HenryTanRidley/Exoknee/Mechanical/Photo/idlergear.jpg

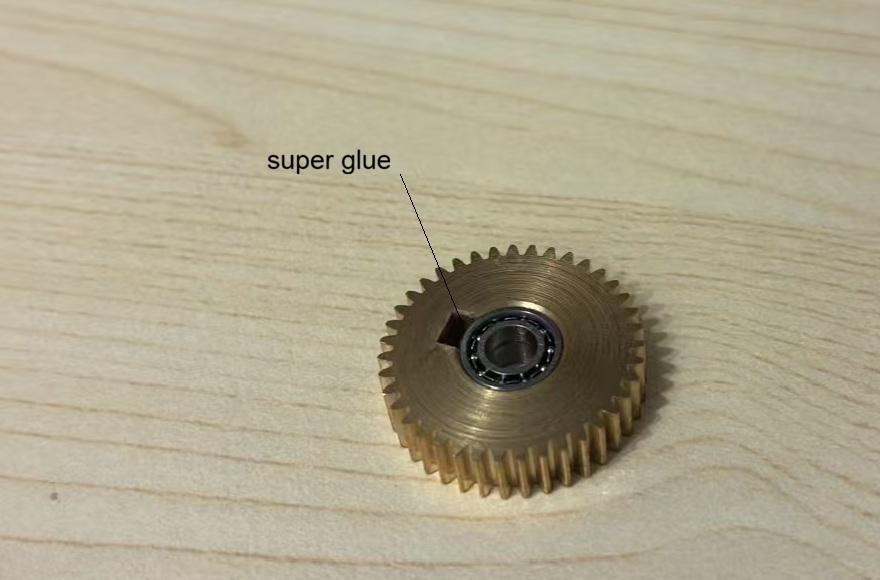
Mechanical/Photo/idlergear.jpg
