HenryTanRidley/Exoknee/Mechanical/Photo/note1.jpg

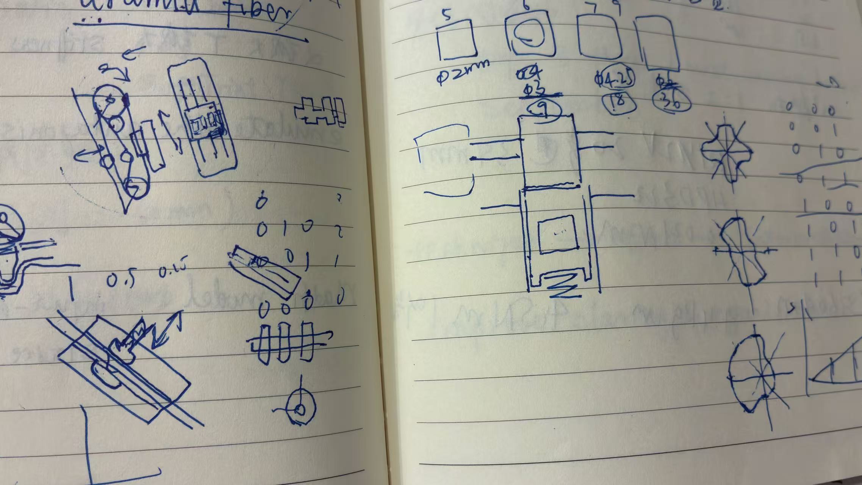
Mechanical/Photo/note1.jpg
