HenryTanRidley/Exoknee/Mechanical/Photo/camaxis.jpg

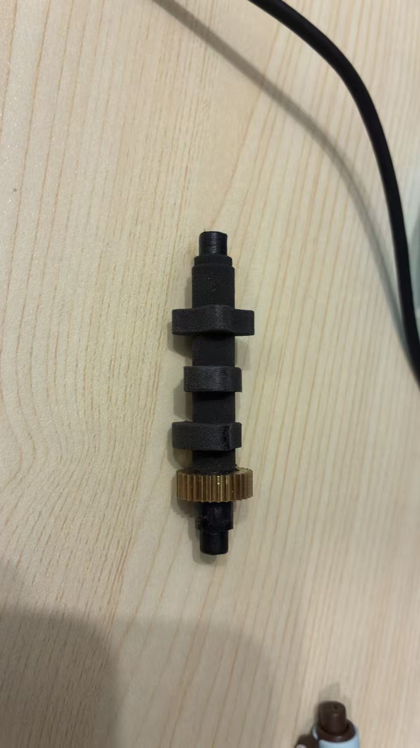
Mechanical/Photo/camaxis.jpg
