HenryTanRidley/Exoknee/Mechanical/Photo/note2.jpg

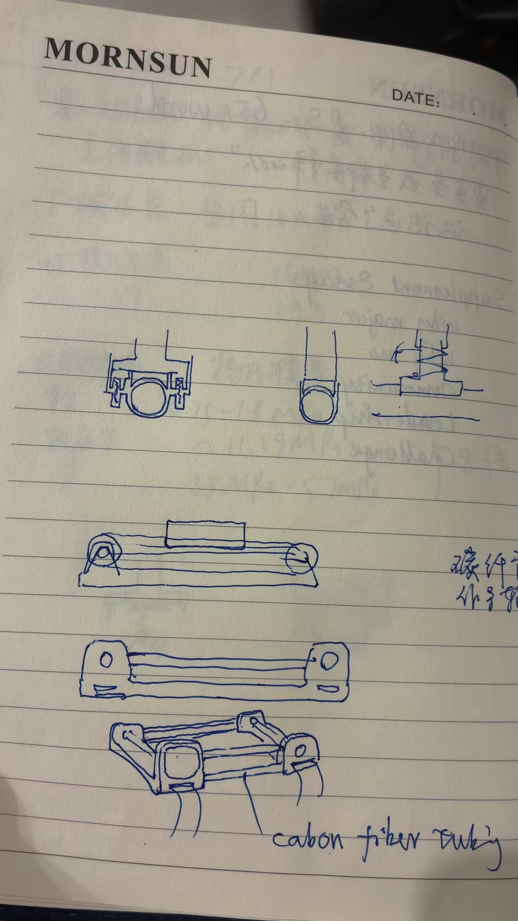
Mechanical/Photo/note2.jpg
