HenryTanRidley/Exoknee/Mechanical/Final/tuoban_yuan_prt.stp

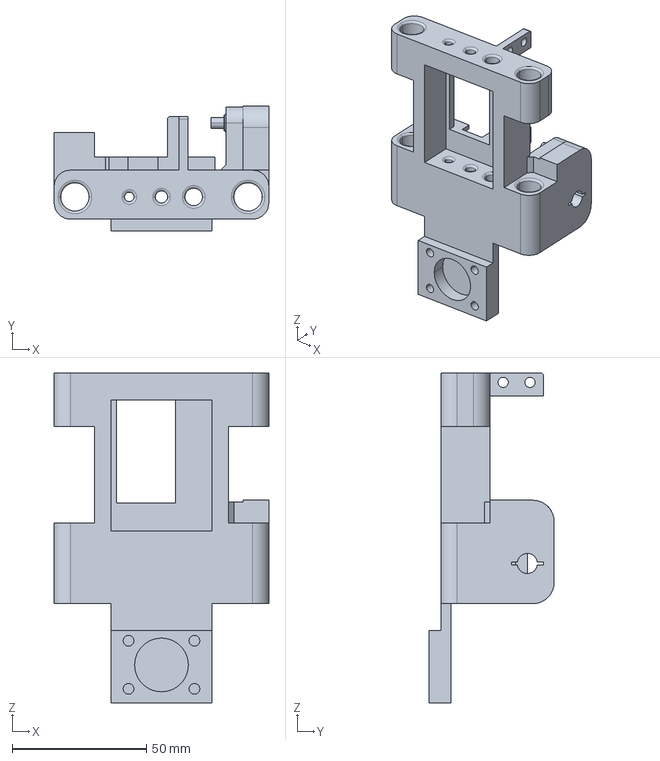
[picture p17: CAD file, 2026-08-20]
Mechanical/Final/tuoban_yuan_prt.stp
80.0 x 46.7 x 123.0 mm
