HenryTanRidley/Exoknee/Mechanical/jointcover.stp

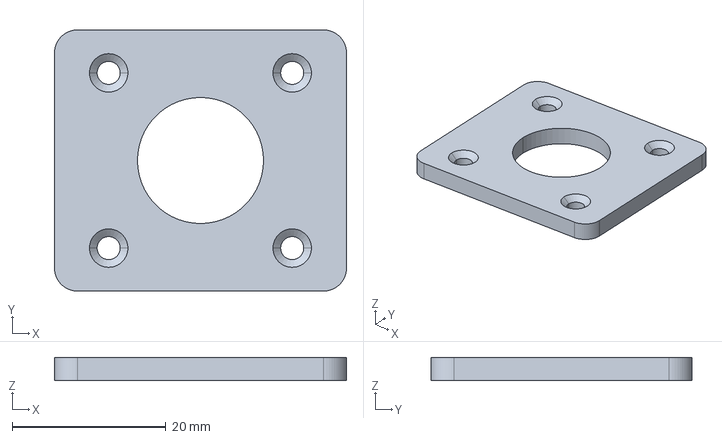
[picture p18: CAD file, 2026-07-24]
Mechanical/jointcover.stp
38.0 x 34.0 x 3.00 mm
