HenryTanRidley/Exoknee/Mechanical/link1.stp

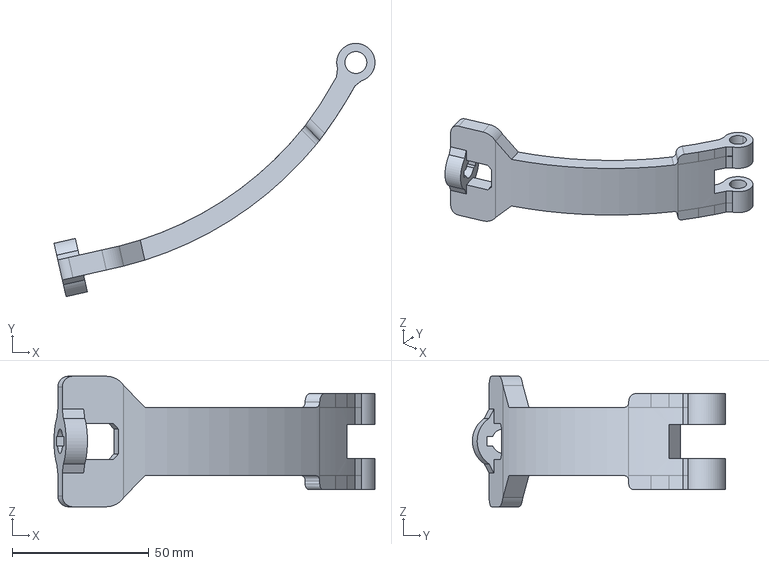
[picture p19: CAD file, 2026-07-24]
Mechanical/link1.stp
117.3 x 92.6 x 47.7 mm
