HenryTanRidley/Exoknee/Mechanical/Final/brake1_prt.stp

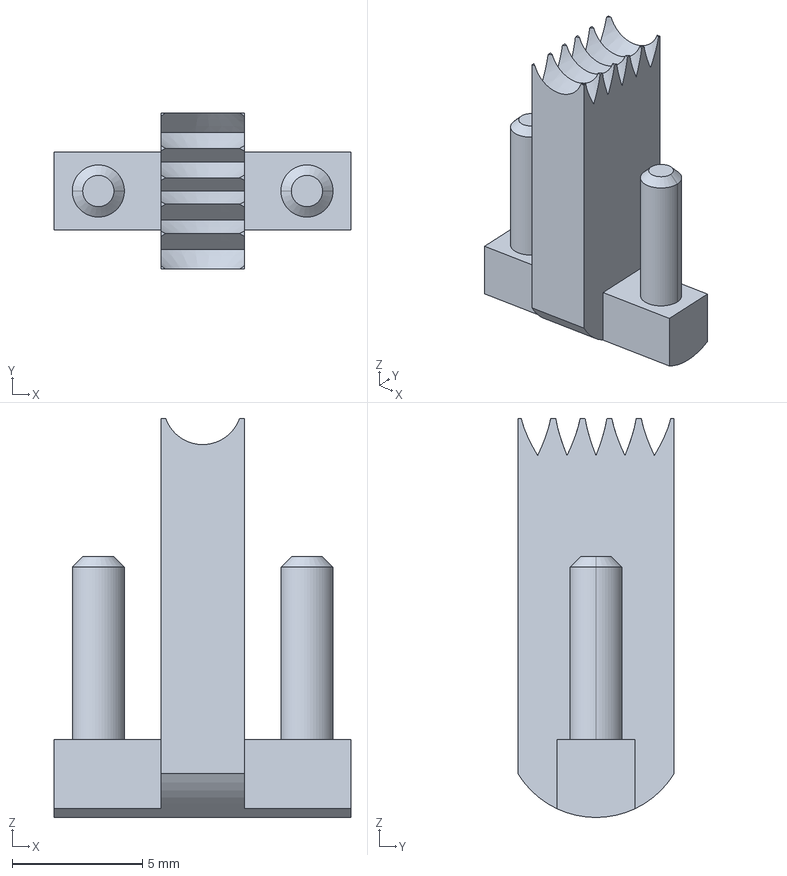
[picture p20: CAD file, 2026-08-11]
Mechanical/Final/brake1_prt.stp
11.4 x 6.00 x 15.3 mm
