HenryTanRidley/Exoknee/Mechanical/link3.stp

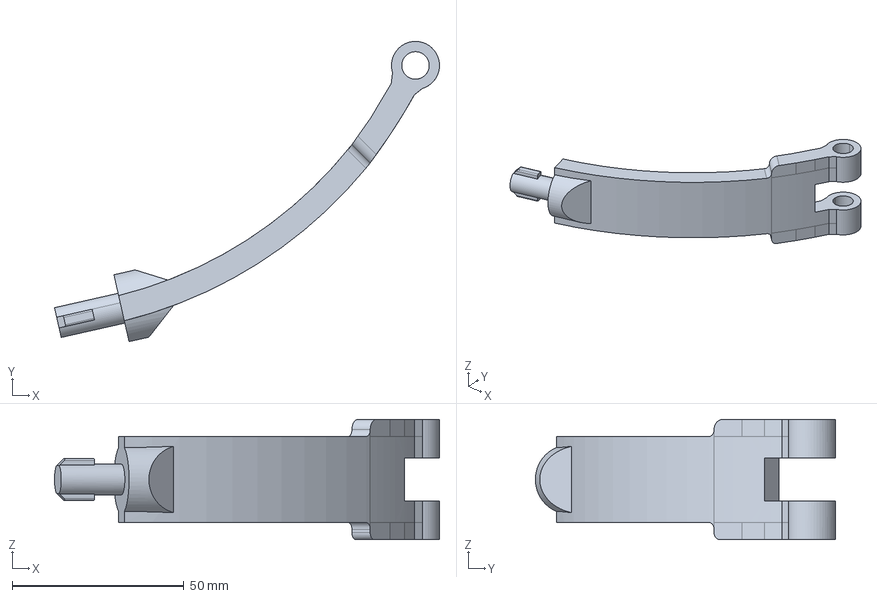
[picture p21: CAD file, 2026-07-24]
Mechanical/link3.stp
112.2 x 87.5 x 35.0 mm
