HenryTanRidley/Exoknee/Mechanical/Final/brake3_prt.stp

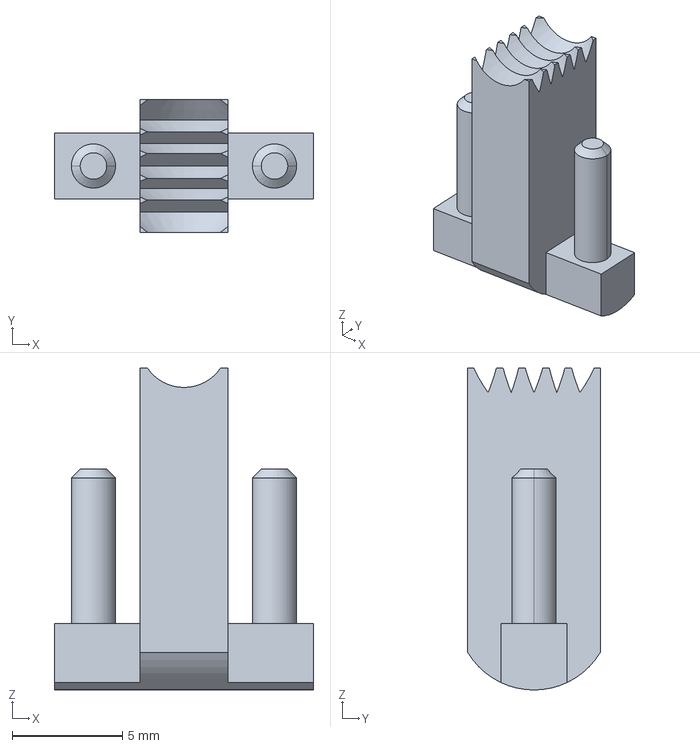
[picture p22: CAD file, 2026-08-11]
Mechanical/Final/brake3_prt.stp
11.7 x 6.00 x 14.6 mm
