HenryTanRidley/Exoknee/Mechanical/jointcover2.stp

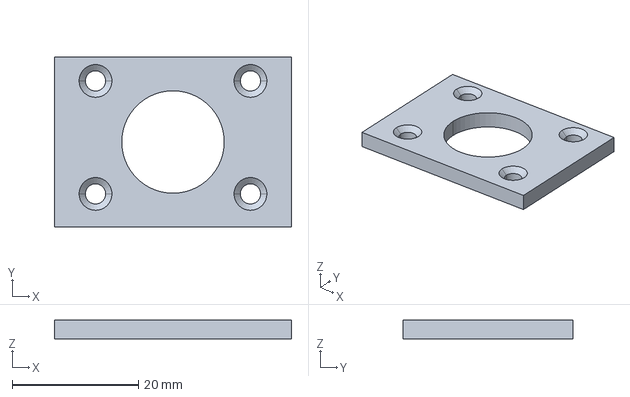
[picture p23: CAD file, 2026-07-24]
Mechanical/jointcover2.stp
37.6 x 27.0 x 3.00 mm
