HenryTanRidley/Exoknee/Mechanical/brake2.stp

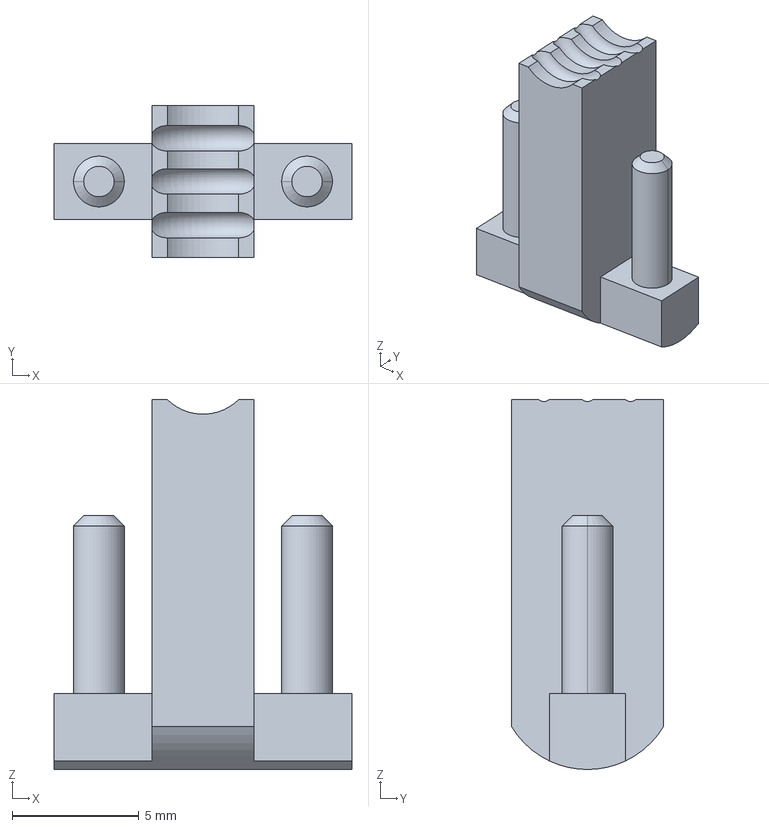
[picture p24: CAD file, 2026-07-24]
Mechanical/brake2.stp
11.7 x 6.00 x 14.6 mm
