HenryTanRidley/Exoknee/Mechanical/brake3.stp

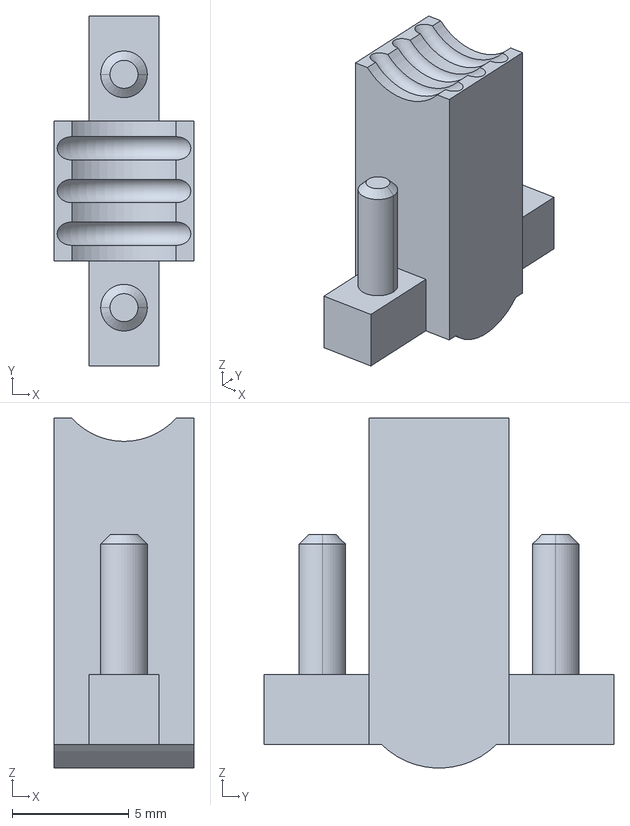
[picture p25: CAD file, 2026-07-24]
Mechanical/brake3.stp
6.00 x 15.0 x 15.0 mm
