HenryTanRidley/Exoknee/Mechanical/Final/rail_tubing_prt.stp

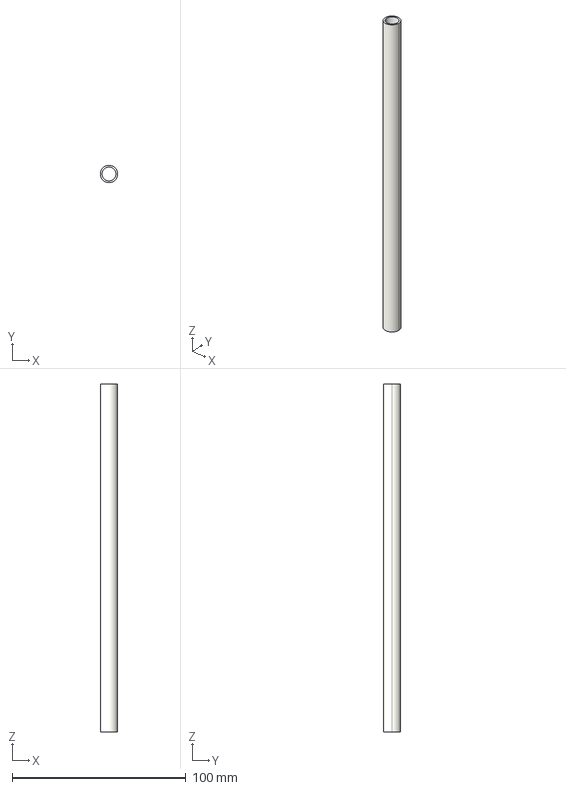
[picture p26: CAD file, 2026-08-09]
Mechanical/Final/rail_tubing_prt.stp
10.0 x 10.0 x 200.0 mm
