HenryTanRidley/Exoknee/Mechanical/brace2.stp

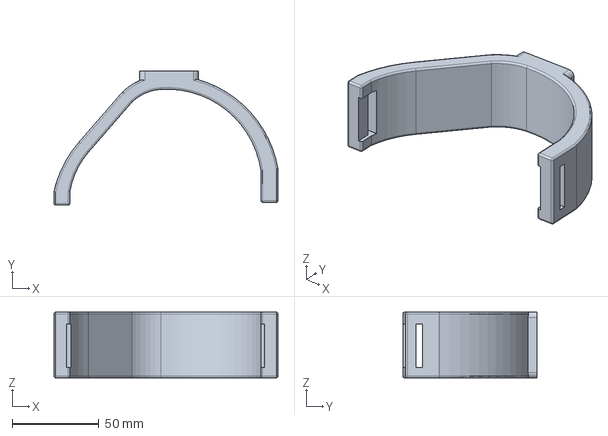
[picture p27: CAD file, 2026-07-24]
Mechanical/brace2.stp
129.3 x 77.6 x 38.0 mm
