HenryTanRidley/Exoknee/Mechanical/Final/35motor_prt.stp

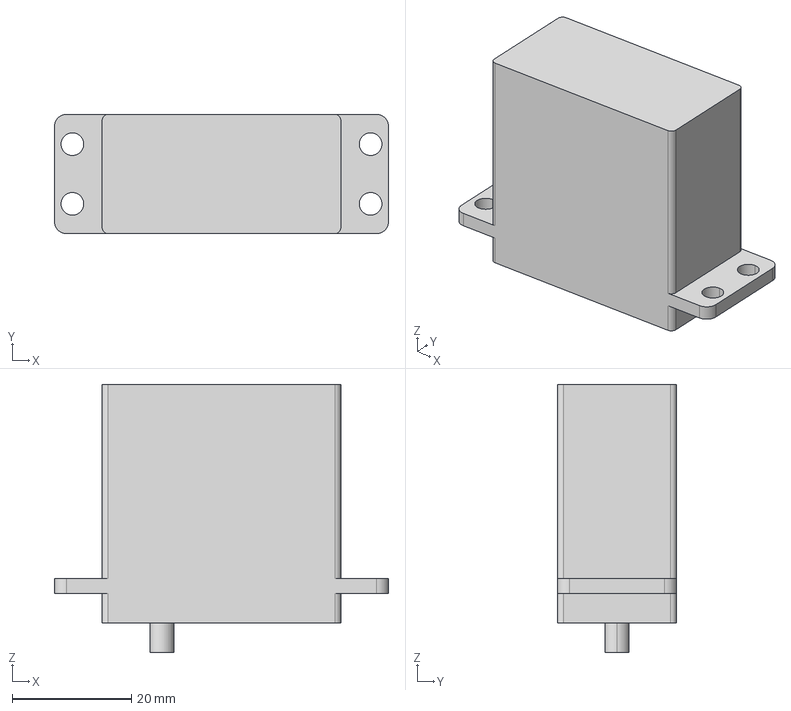
[picture p28: CAD file, 2026-08-09]
Mechanical/Final/35motor_prt.stp
56.0 x 20.0 x 45.0 mm
