HenryTanRidley/Exoknee/Mechanical/Final/link1_prt.stp

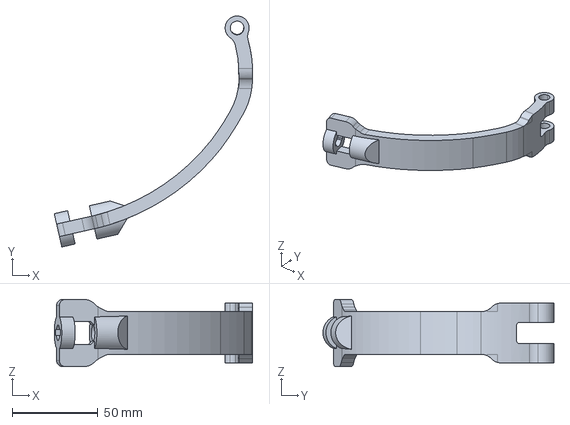
[picture p29: CAD file, 2026-08-09]
Mechanical/Final/link1_prt.stp
115.9 x 134.9 x 39.2 mm
