HenryTanRidley/Exoknee/Mechanical/joint1.stp

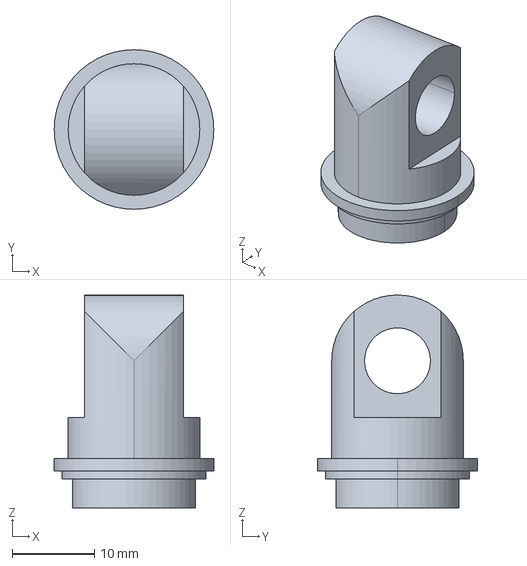
[picture p30: CAD file, 2026-07-24]
Mechanical/joint1.stp
19.4 x 19.4 x 25.9 mm
