HenryTanRidley/Exoknee/Mechanical/brake1.stp

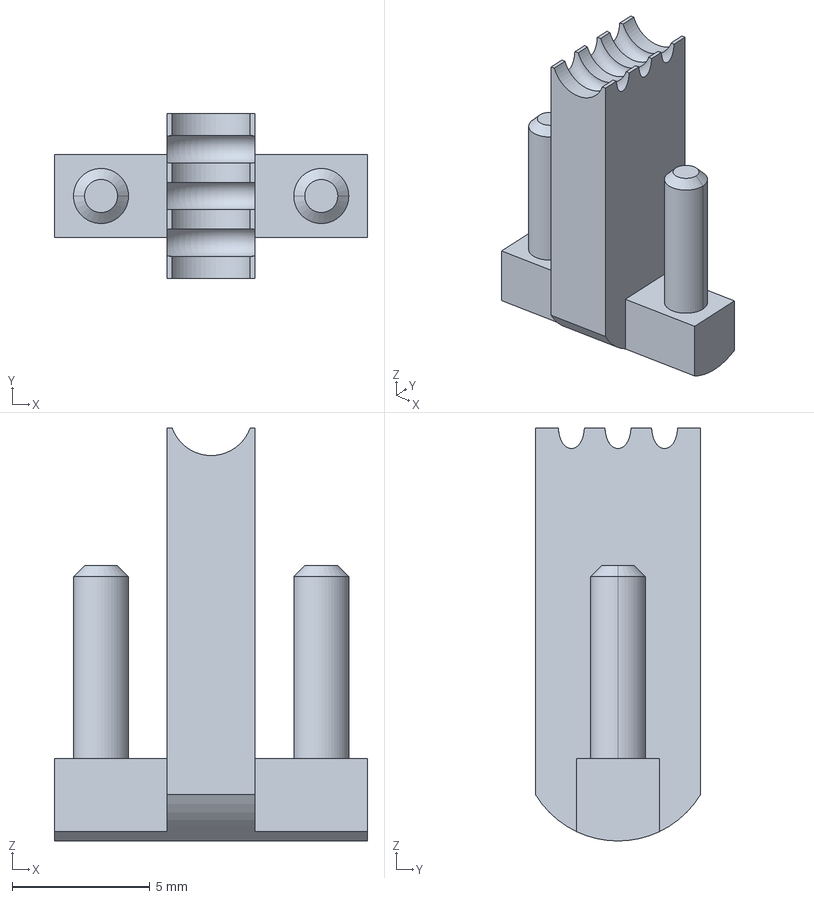
[picture p31: CAD file, 2026-07-24]
Mechanical/brake1.stp
11.4 x 6.00 x 15.0 mm
