HenryTanRidley/Exoknee/Mechanical/Final/bear3_prt.stp

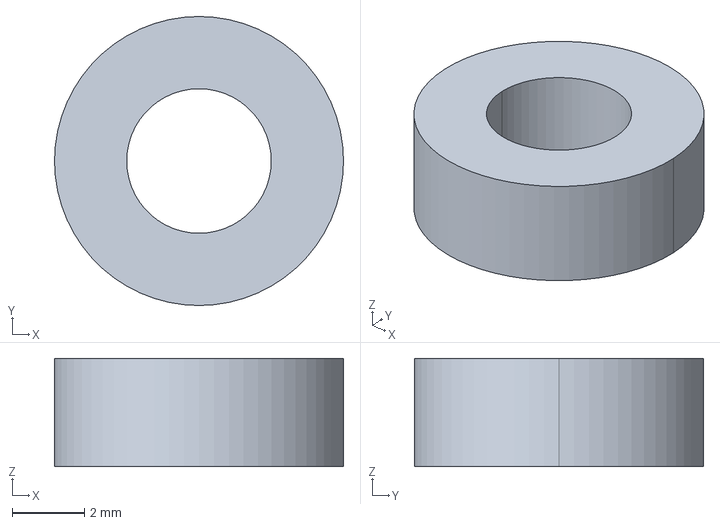
[picture p32: CAD file, 2026-08-09]
Mechanical/Final/bear3_prt.stp
8.00 x 8.00 x 3.00 mm
