HenryTanRidley/Exoknee/Mechanical/Final/bear4-2_prt.stp

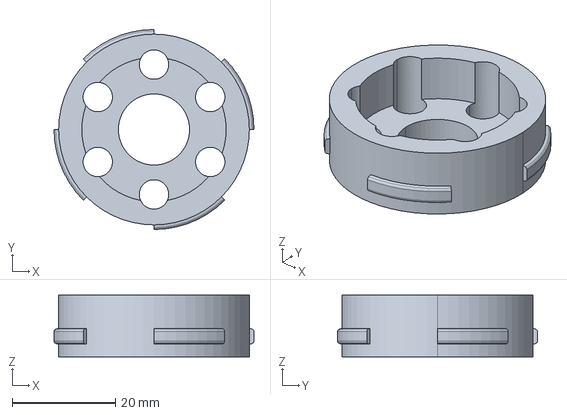
[picture p33: CAD file, 2026-08-09]
Mechanical/Final/bear4-2_prt.stp
38.8 x 38.8 x 12.0 mm
