HenryTanRidley/Exoknee/Mechanical/Final/wheel2_prt.stp

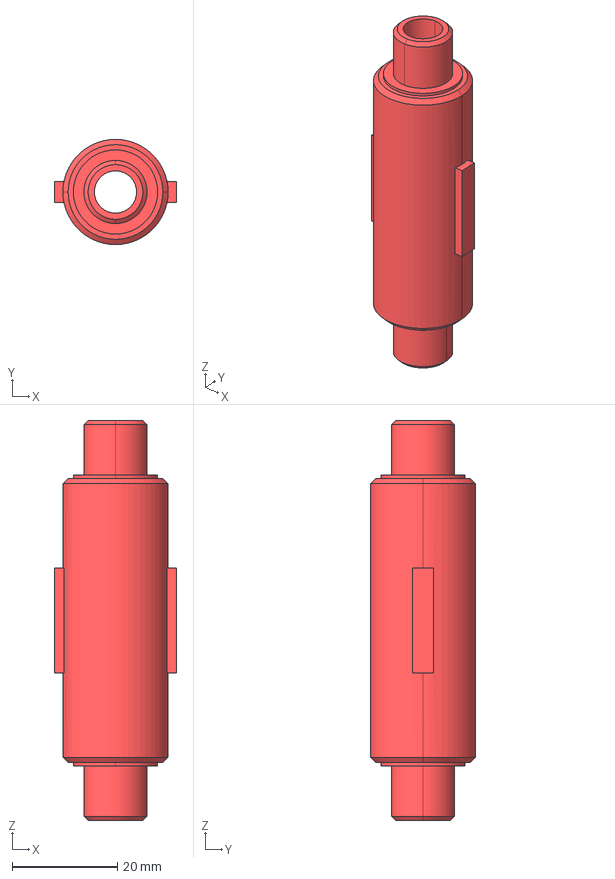
[picture p34: CAD file, 2026-08-09]
Mechanical/Final/wheel2_prt.stp
23.2 x 20.0 x 76.0 mm
