HenryTanRidley/Exoknee/Mechanical/Final/camgear2_prt.stp

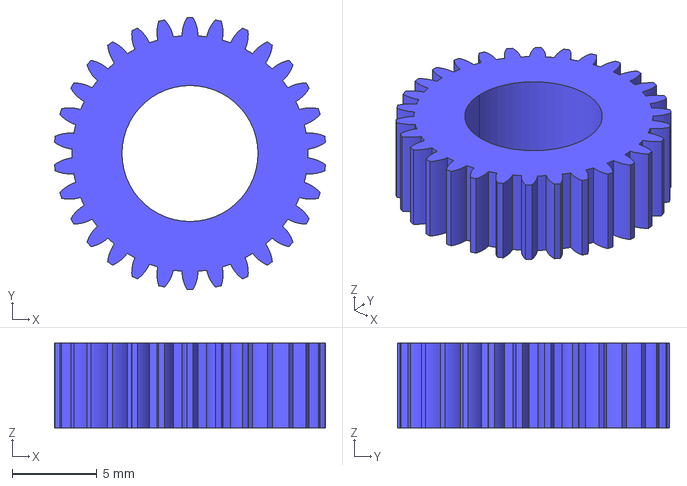
[picture p35: CAD file, 2026-08-09]
Mechanical/Final/camgear2_prt.stp
15.9 x 16.0 x 5.00 mm
