HenryTanRidley/Exoknee/Mechanical/Final/halfwheel_prt.stp

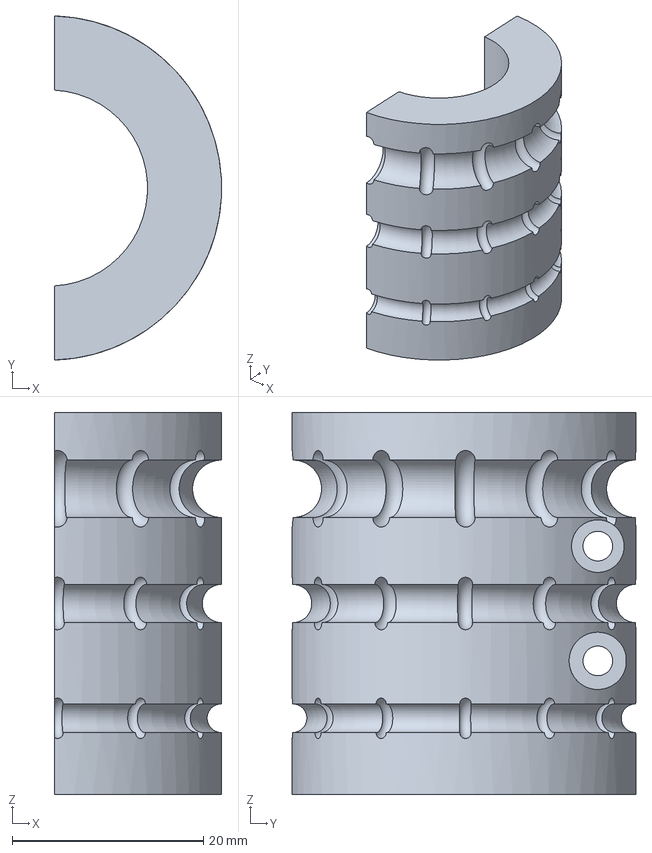
[picture p36: CAD file, 2026-08-09]
Mechanical/Final/halfwheel_prt.stp
17.5 x 36.0 x 40.0 mm
