HenryTanRidley/Exoknee/Mechanical/Final/rope1_prt.stp

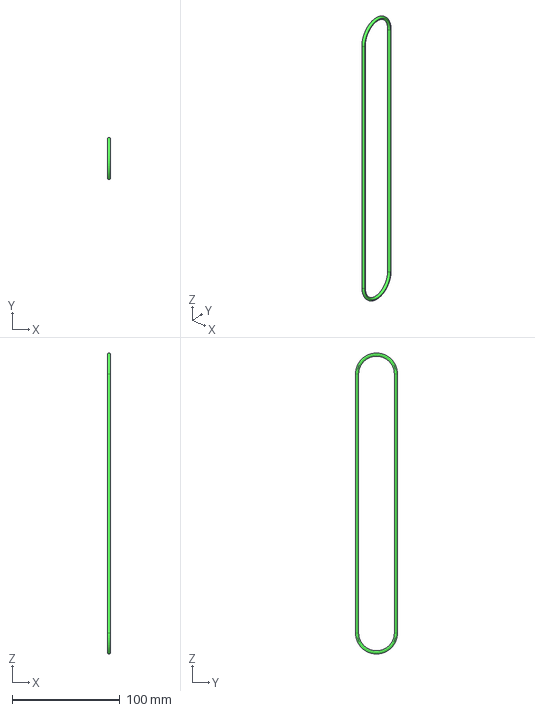
[picture p37: CAD file, 2026-08-09]
Mechanical/Final/rope1_prt.stp
3.00 x 39.0 x 279.0 mm
