HenryTanRidley/Exoknee/Mechanical/Final/bear4_prt.stp

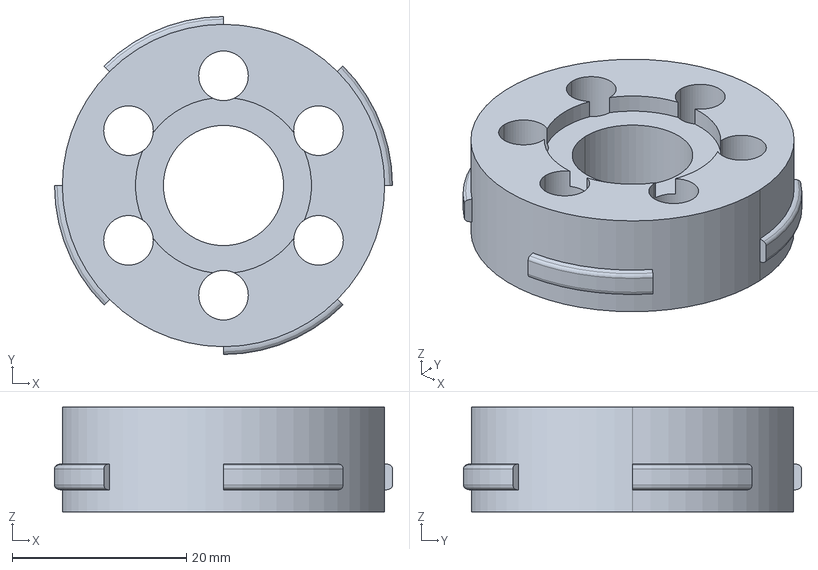
[picture p38: CAD file, 2026-08-09]
Mechanical/Final/bear4_prt.stp
38.8 x 38.8 x 12.0 mm
