HenryTanRidley/Exoknee/Mechanical/Final/link3_prt.stp

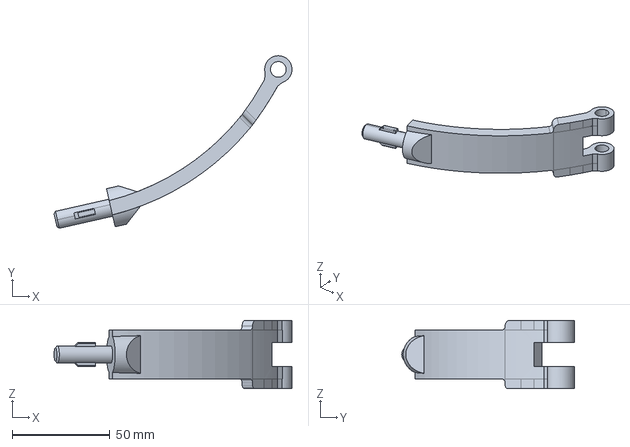
[picture p39: CAD file, 2026-08-09]
Mechanical/Final/link3_prt.stp
121.7 x 88.2 x 35.0 mm
