HenryTanRidley/Exoknee/Mechanical/Final/tower1_prt.stp

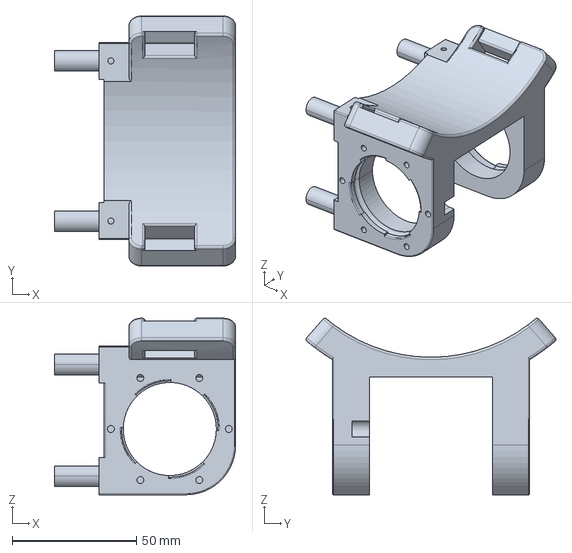
[picture p40: CAD file, 2026-08-09]
Mechanical/Final/tower1_prt.stp
73.0 x 100.7 x 71.1 mm
