HenryTanRidley/Exoknee/Mechanical/Final/motorgear_prt.stp

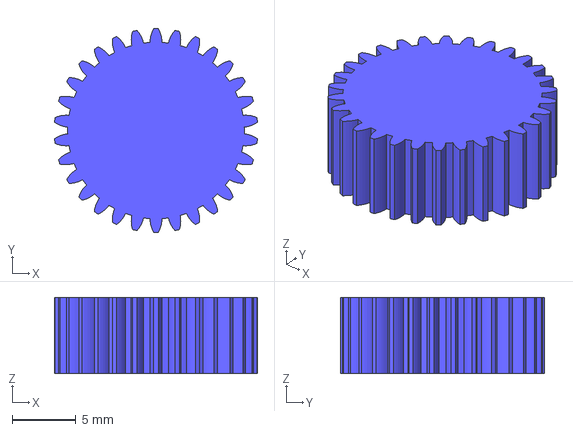
[picture p41: CAD file, 2026-08-09]
Mechanical/Final/motorgear_prt.stp
15.9 x 16.0 x 6.00 mm
