HenryTanRidley/Exoknee/Mechanical/Final/rope2_prt.stp

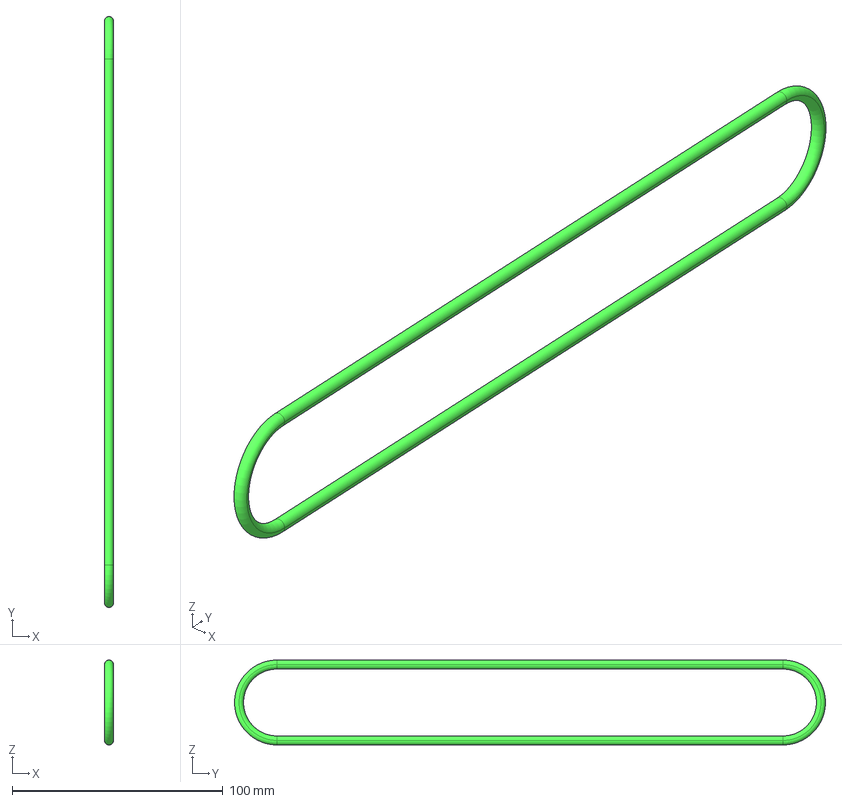
[picture p42: CAD file, 2026-08-09]
Mechanical/Final/rope2_prt.stp
4.30 x 280.3 x 40.3 mm
