HenryTanRidley/Exoknee/Mechanical/Final/zhoucheng_prt.stp

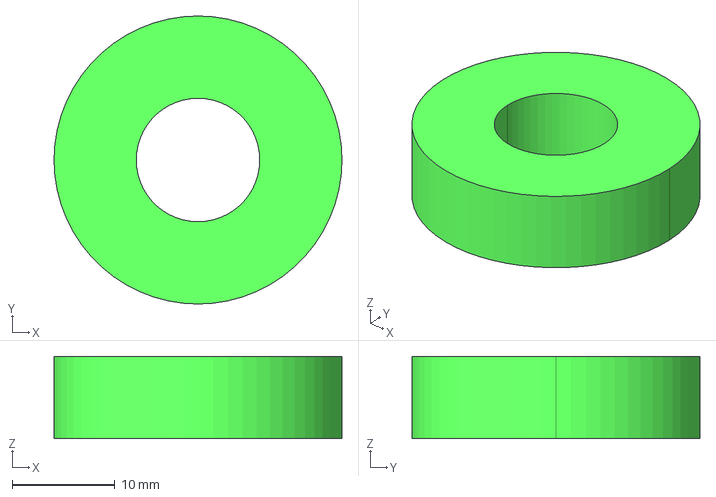
[picture p43: CAD file, 2026-08-09]
Mechanical/Final/zhoucheng_prt.stp
28.0 x 28.0 x 8.00 mm
