HenryTanRidley/Exoknee/Mechanical/Final/motor_prt.stp

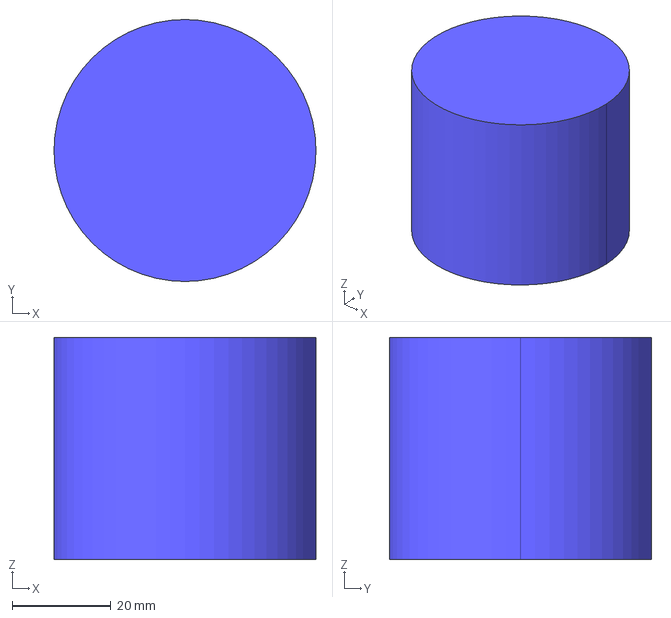
[picture p44: CAD file, 2026-08-09]
Mechanical/Final/motor_prt.stp
53.0 x 53.0 x 45.0 mm
