HenryTanRidley/Exoknee/Mechanical/Final/rope3_prt.stp

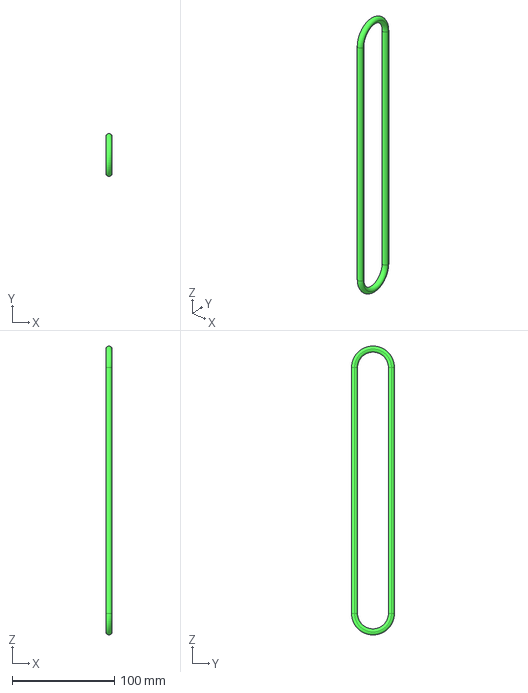
[picture p45: CAD file, 2026-08-09]
Mechanical/Final/rope3_prt.stp
6.00 x 42.0 x 282.0 mm
