HenryTanRidley/Exoknee/Mechanical/Final/interlink_prt.stp

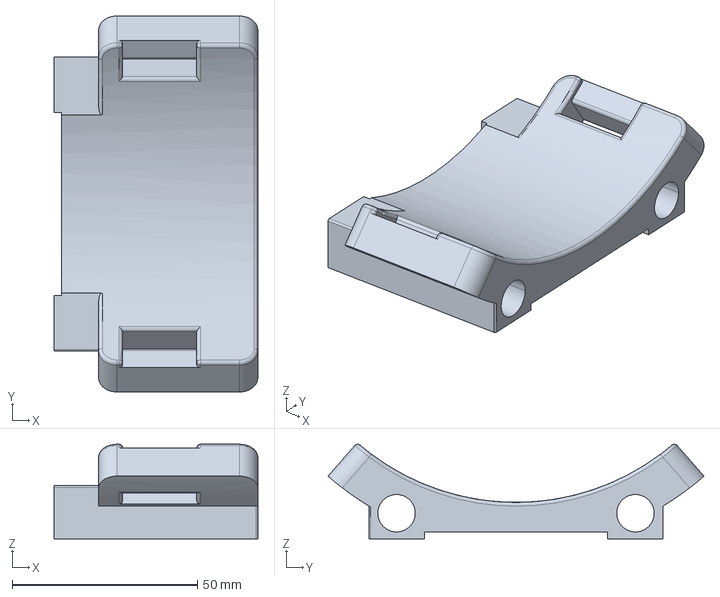
[picture p46: CAD file, 2026-08-09]
Mechanical/Final/interlink_prt.stp
55.0 x 101.5 x 25.5 mm
