HenryTanRidley/Exoknee/Mechanical/Final/bear1_prt.stp

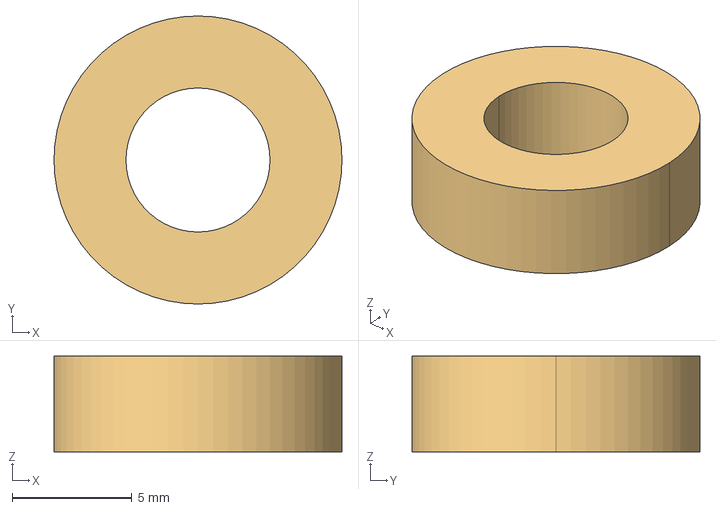
[picture p47: CAD file, 2026-08-09]
Mechanical/Final/bear1_prt.stp
12.0 x 12.0 x 4.00 mm
