HenryTanRidley/Exoknee/Mechanical/Final/flatbear_prt.stp

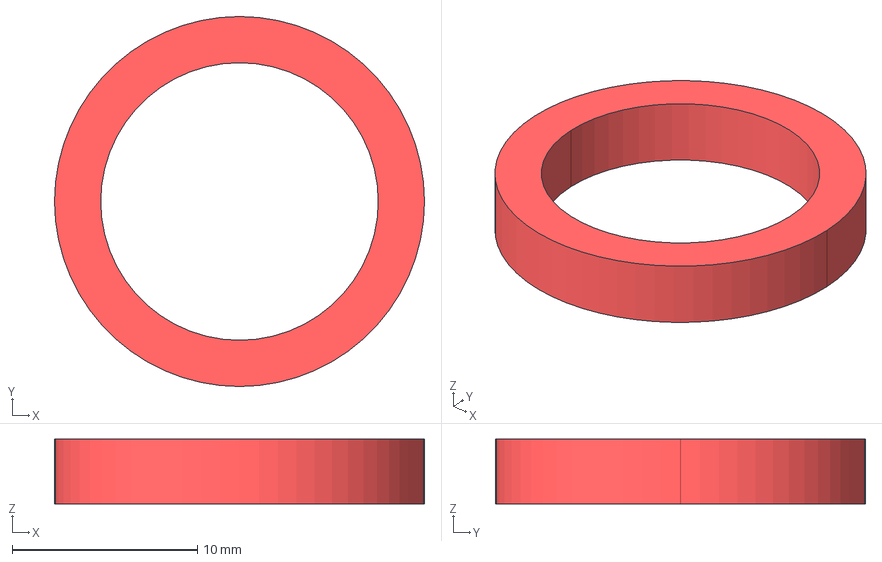
[picture p48: CAD file, 2026-08-09]
Mechanical/Final/flatbear_prt.stp
20.0 x 20.0 x 3.50 mm
