HenryTanRidley/Exoknee/Mechanical/Final/ptfering1_prt.stp

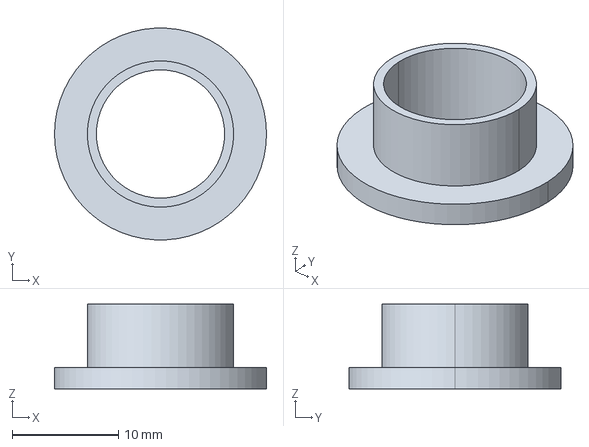
[picture p49: CAD file, 2026-08-09]
Mechanical/Final/ptfering1_prt.stp
20.0 x 20.0 x 8.00 mm
