HenryTanRidley/Exoknee/Mechanical/Final/brace2_prt.stp

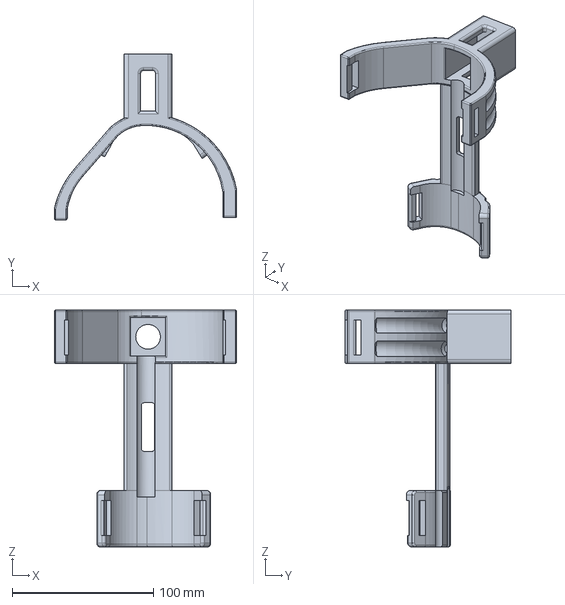
[picture p50: CAD file, 2026-08-09]
Mechanical/Final/brace2_prt.stp
129.3 x 117.6 x 168.0 mm
