HenryTanRidley/Exoknee/Mechanical/Final/wheel_prt.stp

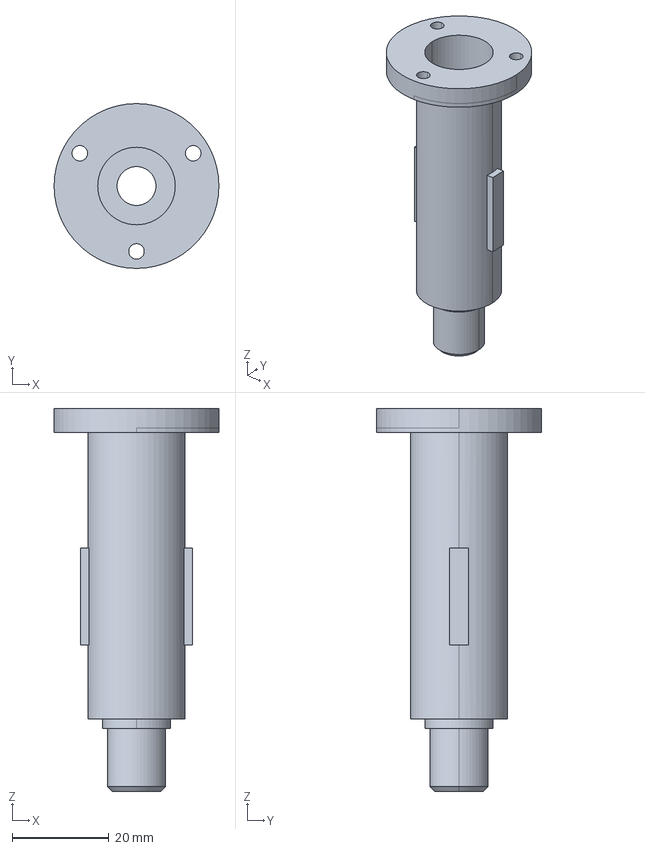
[picture p51: CAD file, 2026-08-09]
Mechanical/Final/wheel_prt.stp
34.0 x 34.0 x 79.0 mm
