HenryTanRidley/Exoknee/Mechanical/Final/camgear_prt.stp

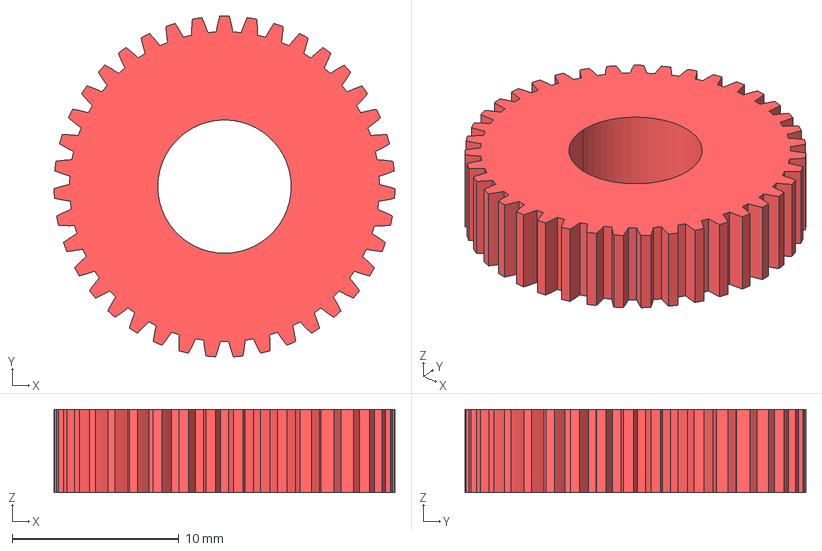
[picture p52: CAD file, 2026-08-09]
Mechanical/Final/camgear_prt.stp
20.5 x 20.5 x 5.00 mm
