HenryTanRidley/Exoknee/Mechanical/Final/axiscover_prt.stp

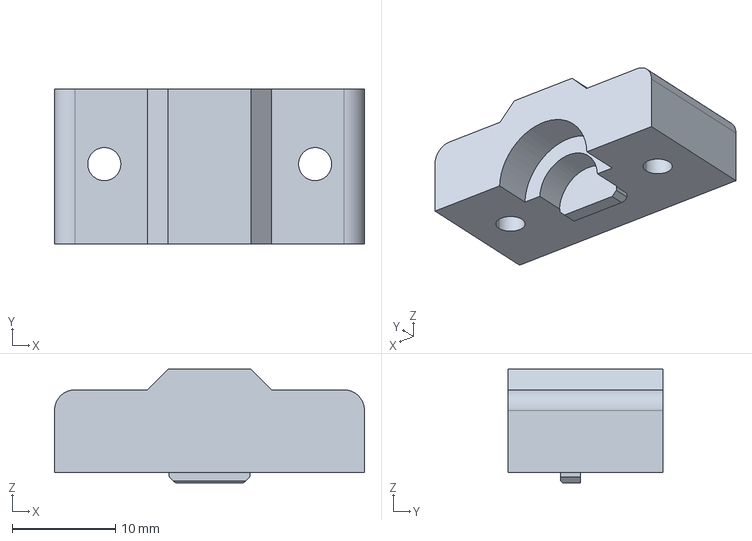
[picture p53: CAD file, 2026-08-09]
Mechanical/Final/axiscover_prt.stp
30.0 x 15.0 x 11.0 mm
