HenryTanRidley/Exoknee/Mechanical/Final/tulun_prt.stp

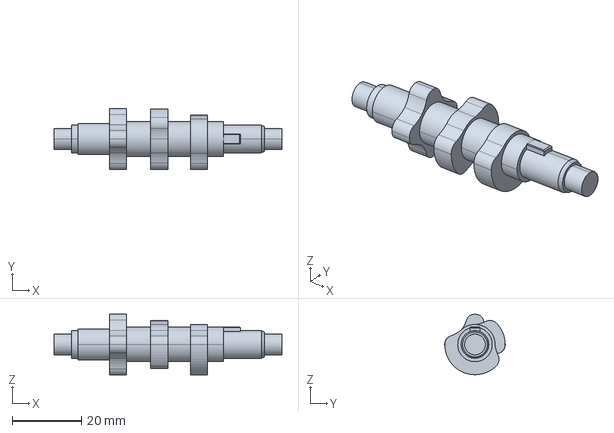
[picture p54: CAD file, 2026-08-09]
Mechanical/Final/tulun_prt.stp
66.0 x 17.5 x 17.5 mm
