HenryTanRidley/Exoknee/(list of files, cad)

Other CAD files:
Mechanical/Final/exoknee_asm.stp
Mechanical/Final/brake2_prt.stp
Mechanical/Final/joint1_prt.stp
Mechanical/Final/jointcover_prt.stp
Mechanical/Final/jointcover2_prt.stp
