HenryTanRidley/Exoknee/Mechanical/Test/Readme.md

Test code using Matlab serial port control
