HenryTanRidley/Exoknee/Mechanical/Photo/test2.jpg

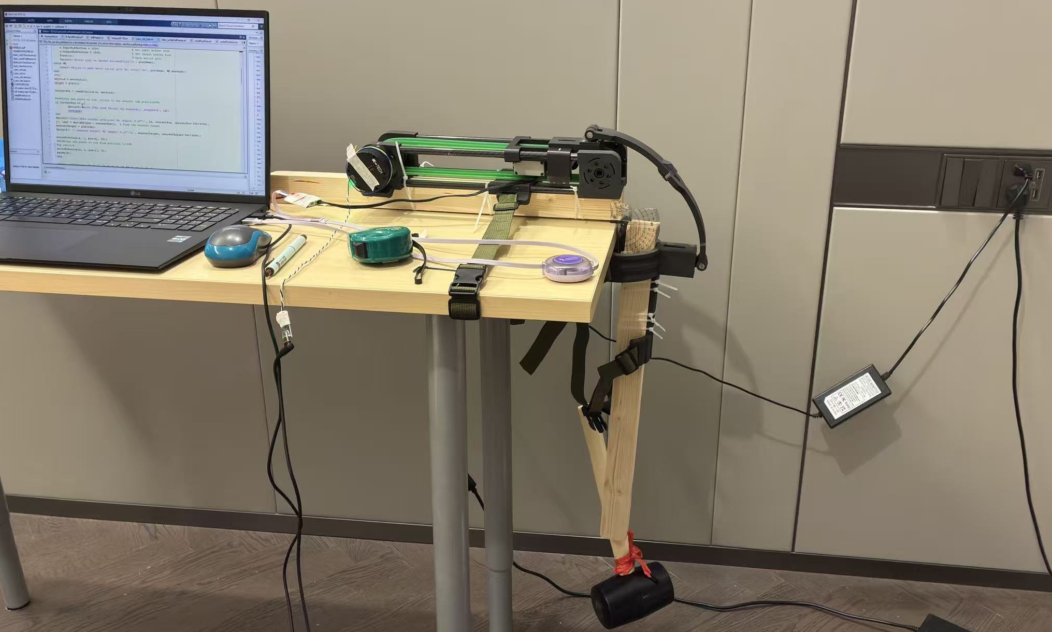
Mechanical/Photo/test2.jpg
