HenryTanRidley/Exoknee/(commit log)

2026-08-09 Add final version notes to Readme.md
    The readme notes that screws and springs for brakes are not included.
2026-08-09 Move jointcover2.stp to Older directory
    [jointcover2.stp]
2026-08-09 Move link1.stp to Older directory
    [link1.stp]
2026-08-09 Move link3.stp to Older directory
    [link3.stp]
